Daedalus-TUM/PP_flying_circus/README.md

PP_flying_circus
================

Projektpraktikum Team Flying Circus
