Daedalus-TUM/PP_flying_circus/doku.odt

REGELUNG

#include <PID_v1.h>

void init_PID() {

//init PID-Regler für Höhenregelung

hoehePID.SetOutputLimits(-80, 160); //funktioniert ganz gut

hoehePID.SetMode(AUTOMATIC); //aktiviert PID-Regler

hoehePID.SetSampleTime(200); //Sample Time des PID für die Höhenregelung

//init PID-Regler für Richtungsregelung

richtungsPID.SetOutputLimits(-70, 70);

richtungsPID.SetMode(AUTOMATIC); //aktiviert PID-Regler

richtungsPID.SetSampleTime(200); //Sample Time des PID für die Richtungsregelung

}

PID richtungsPID(&phiFusion, &geschwindigkeit_r, &sollPhi, 5, 0.6, 13, DIRECT);

PID hoehePID(&istH, &geschwindigkeitH, &sollH, 5, 0.6, 13, DIRECT);

vood loop(){

hoehePID.Compute();

richtungsPID.Compute();

}

ABWURF

#define out_Abwurf 1

//Abwurf ausführen, wenn Wegpunkt mit Abwurf erreicht

if(receiving[7] == 1) digitalWrite(out_Abwurf,HIGH); //Pin für Abwurf auf High setzen um Paket abzuwerfen

else if(receiving[7] == 50) sollH = 0; //"deaktiviert" Hoehenregelung

else if(receiving[7] == 0) digitalWrite(out_Abwurf,LOW); //Pin für Abwurf auf Low setzen

NRF

void NRF() {

if(Mirf.dataReady()) {

Mirf.getData(receiving);

//NRF Receive Variablen

int receive_distanz=0;

int receive_sollPhi=0;

int receive_phi = 0;

receive_distanz = receiving[2]; // receive high byte

receive_distanz = receive_distanz << 8; // shift high byte to be high 8 bits

receive_distanz |= receiving[3]; // receive low byte as lower 8 bits

receive_sollPhi = receiving[4]; // receive high byte

receive_sollPhi = receive_sollPhi << 8; // shift high byte to be high 8 bits

receive_sollPhi |= receiving[5]; // receive low byte as lower 8 bits

sollH = receiving[6]; //Uebernehmen der neuen Sollhoehe

receive_phi = receiving[8]; // receive high byte

receive_phi = receive_phi << 8; // shift high byte to be high 8 bits

receive_phi |= receiving[9]; // receive low byte as lower 8 bits

sollPhi = receive_sollPhi;

phiIPS = receive_phi;

}

sending[2] = IPS;

sending[3] = istH;

sending[4] = sollH;

sending[5] = geschwindigkeit_r;

sending[6] = yaw;

sending[7] = sollPhi;

Mirf.send(sending);

while(Mirf.isSending()){

}

}
