Daedalus-TUM/PP_flying_circus/AbschlussprÃ¤sentation/Abschlusspraesentation_Flying_Circus.pdf

# Abschlusspräsentation

Team Flying Circus

Adam Ivankay, Thomas Riethorst, Tobias Eden, Lorenz Kenndoff

Autoren: Adam Ivankay, Thomas Riethorst

# Zielsetzung

- Konstruktion einer autonom flugfähigen Gondel
- kein Zugriff auf das Steuerungssystem während des Wettfluges

08.07.14 2/13 Team Flying Circus Thomas Riethorst, Adam Ivankay, Tobias Eden, Lorenz Kenndoff - Abwurf eines Rettungspakets an einer zuvor definierten Position - Das Luftschiff darf während der gesamten Mission nicht höher als 2 Meter und tiefer als 0,5 Meter fliegen - Die Dauer eines Durchlaufs beträgt maximal 15 Minuten, wobei zwei Durchläufe erlaubt sind

# Vergleich Projektplan: Hardware

- Grundgerüst aus Karbonstangen und herausnehmbaren Komponenten
- Letztendlich kein Umstieg auf zwei Höhenmotoren
- Dual-IPS wurde benutzt und optimiert
- Zusätzliche Bodenstationen
- Funkverbindung NRF-Modul anstatt Xbee
08.07.14 | Team Flying Circus Thomas Riethorst, Adam Ivankay, Tobias Eden, Lorenz Kenndoff | 3/13

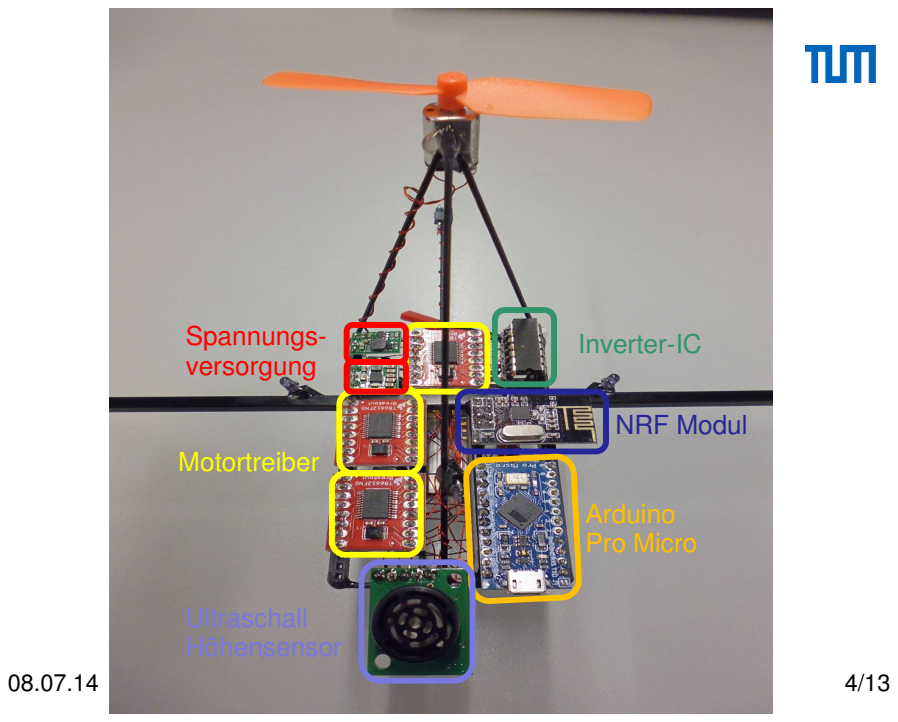
[picture p9: page 4]
Spannungs-; Inverter-IC; Motortreiber; Arduino Pro Micro; NRF Modul; Ultraschall Höhensensor; versorgung

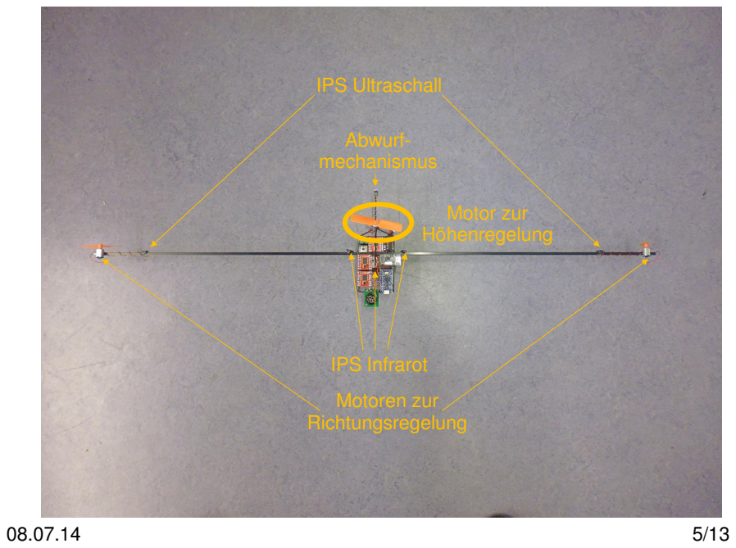
[picture p10: page 5]
IPS Ultraschall; Motor zur Höhenregelung; Abwurf- mechanismus; IPS Infrarot; Motoren zur Richtungsregelung

Gondel-Software:
- Regelung, Sensorik und Motoransteuerung auf dem Arduino - Statt Wegpunkten werden ein Winkel, eine Distanz und eine

# Vergleich Projektplan: Software

Höhe an die Gondel übermittelt

PC-Software:
- Koordinatensystem nach Norden ausgerichtet
- Wegpunkte werden vorher eingetragen und nicht berechnet
08.07.14 | Team Flying Circus Thomas Riethorst, Adam Ivankay, Tobias Eden, Lorenz Kenndoff | 6/13

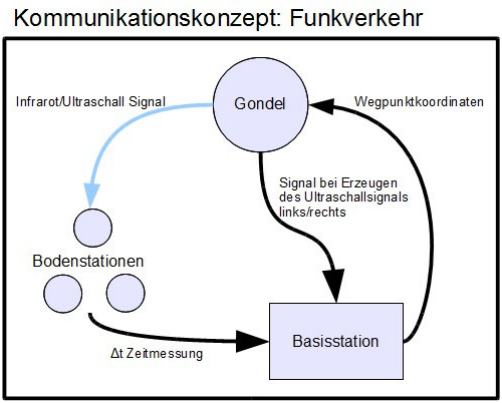
[picture p11: figure]

08.07.14 | Team Flying Circus Thomas Riethorst, Adam Ivankay, Tobias Eden, Lorenz Kenndoff | 7/13

Probleme – Lösungen: - Gondel zerfallen, nicht fest

genug - Genauigkeit vom IPS | - Mehr Verstrebungen eingebaut, mehr Kleber verwendet - mehr Bodenstationen,

physikalische Eigenschaften ausgenutzt, Software überarbeitet - IMU-Board sehr unzuverlässig - Zeitproblem mit Löten der

Bodenstationen | - Richtungsbestimmung über IPS - Mehr Fokus auf dieses Arbeitspaket
08.07.14 | Team Flying Circus Thomas Riethorst, Adam Ivankay, Tobias Eden, Lorenz Kenndoff | 8/13

Probleme – Lösungen: - Selbstimplementierter PID-

Regler nicht funktionsfähig - Fehler im Code - Ausrichtung der Gondel | - Arduino PID Library verwendet - stundenlanges Troubleshooting - zwei IPS-Sender implementiert - Synchronisationsprobleme bei

Dual-IPS - fehleranfällige IPS-

Bodenstationen | - Softwarearchitektur des IPS umschreiben - Verbesserungen im Hardwareaufbau und Layout
08.07.14 | Team Flying Circus Thomas Riethorst, Adam Ivankay, Tobias Eden, Lorenz Kenndoff | 9/13

# Was wurde erreicht?

- Sehr gut funktionierende Höhenregelung implementiert
- Implementierung der Richtungsregelung
- IMU-Rohdaten auslesen und in Richtungswerte umrechnen (Kompass)
- IPS Erweiterungen in Hardware und Software
- stabile Kommunikation zwischen Gondel und PC
- funktionierende Ausrichtung der Gondel
- diverse Testflüge
- zuverlässiger Abwurfmechanismus
08.07.14 | Team Flying Circus Thomas Riethorst, Adam Ivankay, Tobias Eden, Lorenz Kenndoff | 10/13

# Was wurde (noch) nicht erreicht? – Warum?

- vollständige Implementierung
der IPS-Software
- Dokumentation unvollständig
- Python sehr zeitaufwändig - nur einer im Team konnte Python
- Nachlässigkeit der Teammitglieder
- Testflüge für Richtungsregelung im Gesamtsystem
- Aufbau ausreichender Anzahl von Bodenstationen
- IPS-Software nicht vollständig und Simulation nicht aussagekräftig
- mangelnde Unterstützung des zweiten Teams, bedingt durch unzureichende
Kommunikationsbereitschaft
08.07.14 | Team Flying Circus Thomas Riethorst, Adam Ivankay, Tobias Eden, Lorenz Kenndoff | 11/13

# Team - Probleme

- Im späteren Verlauf auftretende Unklarheiten, was als nächstes gemacht werden sollte
- Prioritätensetzung und Zeitaufteilung
- Synchronisation und Abhängigkeit der Arbeitspakete und damit
- kein eindeutig definierter Teamleiter
08.07.14 | Team Flying Circus Thomas Riethorst, Adam Ivankay, Tobias Eden, Lorenz Kenndoff | 12/13

# Persönliche Lernerfolge

- Adam: Erste Erfahrungen in der Elektrotechnik, Verständnis von Mikrocontrollern erweitert, Praktische Anwendungen in der Regelungstechnik, Teamwork, Eigeninitiative
- Lorenz: Verbindung von Software und Hardware, praktische Erfahrungen, Programmierkenntnisse
- Tobias: TBD
- Thomas: Erfahrungen in der Regelungstechnik, Teamwork, Zeitmanagement
08.07.14 | Team Flying Circus Thomas Riethorst, Adam Ivankay, Tobias Eden, Lorenz Kenndoff | 13/13
