Daedalus-TUM/PP_flying_circus/Projektplan Vorlage/projektplan_FlyingCircus.pdf

# Projektplan Team X

### Projektpraktikum Informationsverarbeitung

Tobias Eden, Lorenz Kenndorf, Adam Ivankay, Fabian Kluge

25. April 2014

## Motivation

Das Projektpraktikum Informationsverarbeitung stellt als Hands-on-Projekt die Schnittstelle zwischen Theorie und Praxis dar, welche besonders für Ingenieure von großer Bedeutung ist. Das Thema des autonomen Fluges, welches auch den Schritt in Richtung Forschung macht, bildet damit eine interessante Grundlage für eigene Ideen und Entwicklungen. Dabei werden die während dem Studium angeeigneten Fähigkeiten und Kenntnisse des Teams im Bereich Regelungstechnik und Programmierung erweitert und weiter verbessert. Ein wichtiger Aspekt ist auch der Konkurrenzkampf mit dem anderen Team, da dieser sowohl das Interesse als auch die Motivation aufrecht erhält.

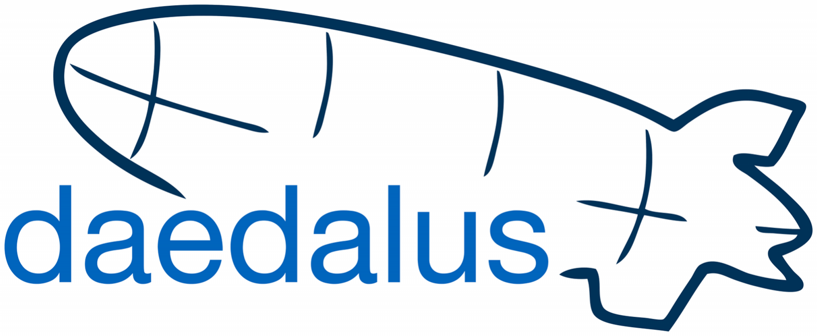
[picture p12: figure]

## 1 Beschreibung des Projekts

### Zielsetzung

In dem dreimonatigen Projektpraktikum soll ein Luftschiff konstruiert werden, welches autonom einen vordefinierten Hindernis-Parcours abfliegt und an einer markierten Stelle ein Rettungspaket abwirft. Dazu müssen folgende Kriterien und Aufgaben eingehalten werden:

-Das Team hat während der Mission keinen Zugriff auf das Steuerungssystem des Luftschiffes -Das Luftschiff soll ein Rettungspaket an einer zuvor definierten Position abwerfen -Das Luftschiff darf während der gesamten Mission nicht höher als 2m und tiefer als 0,5m fliegen -Die Dauer eines Durchlaufs zum Absolvieren der Mission beträgt maximal 15 Minuten, wobei zwei Durchgänge erlaubt sind -Sowohl die Gondel, als auch der Ballon dürfen Hindernisse im Raum nicht berühren

Bei der Entwicklung des Luftschiffes sind Umwelteinflüsse, wie Luftzug, IR-Störung, Helligkeitsund Temperaturänderungen zu beachten. Zusätzlich ist eine gewisse Toleranz in der Tragkraft des Zeppelinballons zu berücksichtigen.

### Ansatz

Unser Team hat sich für einen Ansatz mit drei Motoren entschieden, einen zur Höhenregelung und zwei für die Ausrichtung um die Gierachse. Das Grundgerüst der Gondel soll aus Carbonstangen gefertigt werden, woran der Ausleger für die Motoren befestigt wird. Verwendet wird ein IMU-Board zum Messen von Höhe, Luftdruck, Magnetfeld und Richtung; drei Motortreiber zur Steuerung und das Arduino-Board zur Berechnung der Steuerbefehle.

Für das Projekt stehen uns die Dokumentationen der letztjährigen Teams zur Verfügung, sowie das über die Jahre entwickelte Indoor-Positioning-System (IPS).

Das Gesamtkonzept sieht vor, die Wegfindung am PC zu berechnen. Die aktuellen Positionsdaten sowie die nächsten anzufliegenden Wegpunkte werden am PC berechnet und dann zum Arduino übertragen. Am Arduino wird dann durch die Regelsoftware die notwendige Kursänderung berechnet, die notwendig ist, um den nächsten Wegpunkt, ausgehend von der aktuellen Position, anzufliegen.

### Erfolgskriterien

## 2 Projektumfang und Meilensteine

- Recherche und Planung

– Kostenplanung

– Einarbeitung in das Themengebiet

– Materialbestellung

- Grundgerüst

2

– Design Planung der Bauweise unter Berücksichtigung des Schwerpunktes

– Konstruktion Installation der Bauteile

- Motoren und Motortreiber

– Installation der Motoren und Motortreiber

– Verbindung mit Arduino und Stromversorgung

- Erweiterung des IPS

– Software für Doppelsender konfigurieren

– Testen der Funktionalität des Konzeptes

– Hardware Konstruktion weiterer Bodenstationen

- Sensoren

– IPS Sender installieren

– Auswertung der Genauigkeit der Messdaten

– Optimierung durch Filterung

- Funkverbindung

– Installation des XBEE-Moduls

– Test der Funkverbindung

- Abwurfmechanismus

– Installation der Schaltung

– Test Bestimmung von Drahtdicke und -länge auf experimentelle Weise

- Navigation und Wegfindung

– Auswertung der Messdaten

– Positionsberechnung

– Wegfindungsalgorithmus

– Bestimmung der Wegpunkte

– Umrechnung auf Koordinatensystem der Gondel

- Regelung

– Entwurf der Höhenregelungs- und Richtungsregelungsalgorithmen

– Test Experimentelle Bestimmung der Toleranzbereiche

– Umwelteinflüsse kompensieren

- Dokumentation Festhalten des Projektfortschrittes pro Arbeitspaket

– Materialliste

– Softwarecode mit ausführlichen Kommentaren

3

– Probleme und Lösungen

– Bilder

– Anleitung Navigationssystem, Luftschiffflug

– Quellenangaben

## 3 Projektstruktur

### Grundgerüst

Das Grundgerüst dient der exakten Befestigung aller Komponenten der Gondel.
Als Aufbau unseres Grundgerüsts haben wir uns für einen Skelettaufbau aus Carbonstangen entschieden. Die Stift-/Buchsenleisten werden entsprechend mit den Carbonstangen per Epoxidklebstoff verklebt, um so ein stabiles und dennoch sehr leichtes Grundgerüst für die Gondel zu erhalten. Der Großteil der Elektronik kann somit einfach aufgesteckt und bei Bedarf getauscht werden, sollten Defekte auftreten. Die zwei Motoren zur Richtungsregelung werden an einem Ausleger aus Carbon fixiert, der eine ungefähre Länge von 50cm aufweisen wird.

Die Ultraschall-Sender für das IPS werden jeweils am Ende des Carbonauslegers montiert. Der Infrarotsender wird mittig positioniert. Der Motor zur Höhenregelung wird mittig auf einem kurzen Carbonausleger platziert. Sollten wir aus technischen Gründen (Ausgleich des Drehmoments bei nur einem Motor) auf zwei Motoren für die Höhenregelung umsteigen, werden diese auf dem großen Carbonausleger jeweils auf einer Seite montiert. Um die Trägheit um die Gierachse zu minimieren werden die schwersten Bauteile möglichst nah am Schwer-/Drehpunkt angebracht.

### Motor und Motortreiber

Das Team hat sich primär für einen Antrieb mit drei Motoren entschieden, zwei für die Bewegung in der Ebene, einen für die Höhenregelung. Ein späterer Umstieg auf eine Variante mit zwei Motoren für die Regelung wird offen gehalten. Zur Ansteuerung der Motoren werden insgesamt drei Motorentreiber benötigt. Wir werden kleine, leichte DC-Motoren verwenden, daher können wir einfache Treiber in Form von H-Brücken verwenden. Die Ansteuerung der Treiber wird direkt vom Arduino übernommen. Die Befestigung und Entfernung der Motoren zur Richtungsregelung zum Schwer-/Drehpunkt wird experimentell ermittelt. Dabei muss ein Kompromiss zwischen Leistungsbedarf für eine Drehung und der Problematik einer zu großen Empfindlichkeit durch großen Achsabstand gefunden werden. Bei den Propellern ist darauf zu achten, dass es sich um Typen mit unterschiedlichen Drehrichtungen handeln muss und diese an den Gleichstrommotoren befestigt werden können.

### Sensoren

Das IMU-Board wird, um möglichst störungsfreie Daten zu erhalten, auf der Oberseite des Ballons befestigt. Dadurch können wir die Einflüsse der Magnetfelder der Gleichstrommotoren so gering

4

wie möglich halten. Welche Messdaten verwendet werden können, muss experimentell ermittelt werden. Im Grunde gilt, mit dem Konzept der zwei Ultraschall-Sender auf dem Ausleger lässt sich im Prinzip das IMU-Board einsparen, da es zwei Punkte der Gondel positioniert, und dadurch die Ausrichtung des Ballons auch bestimmt werden kann. Es wird trotzdem verwendet, um mehrere Daten für Höhe, Richtung und Beschleunigung zu erhalten. Des weiteren wird ein Ultraschallsensor zur Höhenmessung eingesetzt.

### Funkverbindung

Um eine Funkverbindung mit dem PC zu erhalten, wird ein XBEE-Modul verwendet. Über diese Kommunikationsverbindung werden dann die Koordinaten von der Basisstation an den Ballon übertragen. Für Tests können damit auch manuelle Steuerungen übernommen werden. Zusätzlich können vom Ballon verschiedene Statuswerte an den PC übertragen werden.

### Abwurfmechanismus

Als Abwurfmechanismus wird ein Transistor zum Durchbrennen eines Drahtes zum Lösen des Pakets verwendet. Die Dicke des Drahtes sowie der benötigte Strom zum Durchbrennen müssen experimentell ermittelt werden. Bei Erreichen der Koordinaten der Abwurfstelle wird die Software im Arduino einen Transistor ansteuern, der dann den dünnen Draht kurzschließt und ihn somit durchbrennt. Dadurch wird das Paket abgeworfen.

### Stromversorgung

Der Akku wird aus zwei Zellen in Serie mit jeweils 3,7V, also insgesamt 7,4V, bestehen. Die Motoren sowie die Ultraschallsender können mit dieser Spannung umgehen. Für die restliche Elektronik werden noch entsprechende Spannungswandler (Schaltregler) für die Spannungen 5V und 3,3V benötigt.

### Navigation und Wegfindung

Aufbauend auf den Positionsdaten des IPS wird auf der Basisstation der optimale Weg durch den Hindernisparcours berechnet. Dieser optimale Weg besteht voraussichtlich aus Kreissegmenten in einem Sicherheitsabstand um die Hindernisse, welche tangential von Hindernis zu Hindernis verbunden werden.

Der Wegfindungsalgorithmus wird bei Flugbegin zunächst einmalig ausgeführt und erzeugt Wegpunkte, welche der Gondel übermittelt werden und von der Regelungssoftware auf der Gondel weiter verarbeitet werden. Der Flug der Gondel wird laufend von der Basisstation auf Kursabweichungen überprüft. Für den Fall dass die Gondel das Ziel verfehlt und somit ein Toleranzwert für das Einhalten des vorgegebenen Kurses überschritten wird, wird der Wegfindungsalgorithmus erneut ausgeführt und die neuen Wegpunkte der Gondel übermittelt.

5

Zur Veranschaulichung der laufenden Prozesse der Navigationssoftware, der Position der Gondel sowie dem Zustand des IPS-Systems soll eine graphische Oberfläche verwendet werden. In der dargestellten Karte werden Hindernisse und spezielle Wegpunkte (z. B. Abwurfort, Ziel) per Eingabe festgelegt. Für Notfälle soll auch eine manuelle Steuerung in die Software integriert werden.

### Regelung

Alle zur Regelung notwendigen Berechnungen werden vom auf der Gondel installierten Arduino-Board übernommen. Es werden lediglich die aktuellen Positionsdaten und die Position des nächsten Wegpunktes an die Gondel übermittelt. Zur Vereinfachung der Berechnungen auf der Gondel werden die Koordinaten vorher auf der Basisstation von einem globalen Koordinatensystem auf das lokale Koordinatensystem der Gondel umgerechnet. Zur Höhenregelung wird ein Ultraschallsensor verwendet, der die Höhe des Ballons ermittelt. Ein entsprechender Höhenregelungsalgorithmus wird direkt auf dem Arduino implementiert.

Bei der Erstellung der Regelung muss darauf geachtet werden, dass das Regelungssystem Umwelteinflüsse wie Zugluft, Druckänderung sowie das durch den einzelnen Höhenregelungsmotor auftretende Drehmoment ausgleichen kann. Weiterhin muss vor allem die Höhenregelung auf den Verlust von ca.1g Gewicht durch Abwurf des Paketes während des Fluges ausgelegt sein.

### Erweiterung des IPS

Beim IPS haben wir uns für einen erweiterten Ansatz entschieden. Da es bei den vorherigen Teams immer wieder zu den Problemen einer genauen Positionsbestimmung sowie Orientierungsbestimmung des Ballons gekommen ist, haben wir hier folgenden Ansatz gewählt. Durch Erweiterung des IPS um die Funktion eines zweiten Senders/Objekts, erhoffen wir uns eine genauere Bestimmung der Position des Ballons. Es werden am Ballon zwei Ultraschallsender jeweils an einem Ende des Auslegers montiert. Diese werden dann abwechselnd, entsprechend den Intervallen des IPS, senden. Dadurch kann die Basisstation zwei Objekte lokalisieren. Die IPS-Software muss entsprechend angepasst werden, sodass die Signale beider Sender getrennt empfangen werden kann.

Durch diese Methode und den geometrischen Eigenschaften der Anordnung der Sender (Abstand zueinander, waagrechte Lage, usw.), erhoffen wir uns somit eine genauere Bestimmung der Position des Ballons. Auch soll es uns dadurch möglich sein, die Orientierung des Ballons berechnen zu können. Diese Werte können dann unterstützend, bzw. sogar ersetzend für das IMU-Board dienen.

Zusätzlich werden weitere IPS-Bodenstationen aufgebaut, um eine bessere Abdeckung zu erreichen. Auch die Neuentwicklung bzw. Verbesserung der Bodenstationen durch gerichtete Ultraschallsensoren wird im Zuge des Projekts getestet und validiert.

6

## 4 Aufwandsabschätzung / Zeitplan

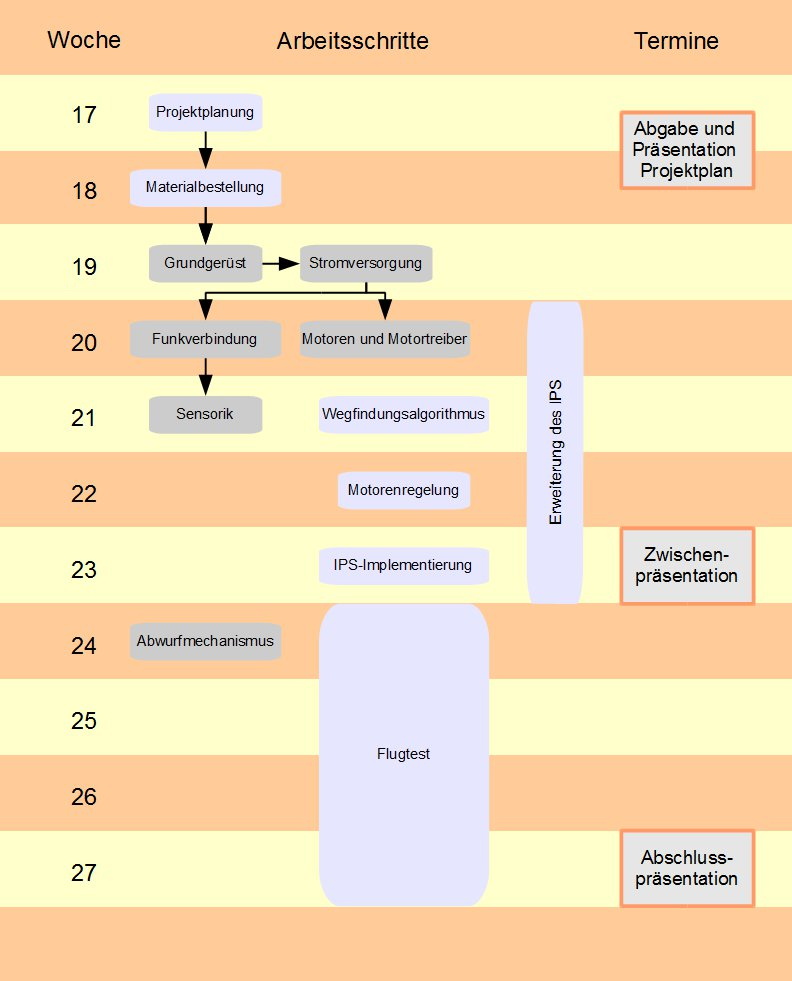
[picture p13: figure]

Wie die Grafik darstellt, werden in den ersten drei Wochen zunächst die Arbeitspakete, welche sich mit der Implementierung der Hardware befassen, bearbeitet. Die darauffolgenden drei Wochen werden zur Entwicklung der Steuersoftware sowie dem Testen der Software auf der Hardware ver-

7

wendet. Während der letzten vier Wochen wird schließlich die Funktionsfähigkeit des Luftschiffes in einem Kreislauf von Test und Optimierung vollendet.

## 5 Material- und Kostenplanung

Die im Bau der Gondel verwendete Hardware (vgl. Absatz „Aufbau des Grundgerüsts“) ist mit den folgenden Kosten verbunden:

Bauteil | Kosten in Euro
==================================
Motoren: | 10
XBEE: | 20
Motorentreiber: | 10
Propeller: | 4
Carbonstangen: | 6
Kleber: | 5
Kabel/Lackdraht: | vorhanden
Arduino-Board: | vorhanden
==================================
Summe: | 55

Für die Motoren und Propeller sind hier bereits Ersatzteile im Preis einkalkuliert.

## 6 Risikoanalyse

Das wichtigste Abbruchkriterium ist das Überschreiten eines geplanten Zeitplans des Arbeitspakets. In dem Fall muss sich das ganze Team auf das Arbeitspaket konzentrieren und daran mitarbeiten. Da es im Team Personen gibt, die im Bereich Informationsverarbeitung Anfänger sind, ist eine realistische Planung vom Zeitaufwand der Arbeitspakete riskant, es müssen eventuell während des Projekts Änderungen vorgenommen werden. Die Evaluation der Meilensteine findet in gemeinsamen Treffen statt, jeweils direkt nach der Deadline des Arbeitspakets.

Ein weiteres Risiko besteht darin, dass die Resourcen nicht vorhanden sind, eventuell nicht zeitig geliefert werden können. Dies kann durch Umplanen und direktem Erscheinen in den Läden korrigiert werden. Der Beschädigung der einzelnen Bauteile wird durch sorgfältiges Einlesen und Informieren so gut wie möglich vorgebeugt.

Hinzu kommt noch, dass bei jedem Arbeitspaket Komplikationen auftreten können, wie z.B. Fehler bei der Programmierung, unvorhergesehene Störungen in der Hardware, konzeptionelle Fehler. In diesen Fällen muss das Team gemeinsam jeweils die bestmögliche Alternative finden (mögliche Risiken: Reichweite des IPS, Fehler im Code, Zwei Punkte-Positionierung des Ballons nicht genau genug, Umwelteinflüsse unberechenbar, Komplikationen mit der Wegberechnung, nicht richtig funktionierendes IPS).

Möglich, aber unwahrscheinlich ist, dass das vorgesehene Budget auf Grund von Beschädigung der Bauelemente nicht ausreicht; in dem Fall muss das Team mit dem Projektleiter konsultieren.

8

## 7 Änderungen des Projektablaufes

Alle auftretenden Änderungen dieses Projektplanes werden beispielsweise in einer Tabelle kurz notiert um Abweichungen und ggf. Änderungen des geplanten Ziels nachvollziehen zu können.

# | DATUM | ÄNDERUNG | GRUND

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
