Daedalus-TUM/PP_flying_circus/Schaltplan.pdf

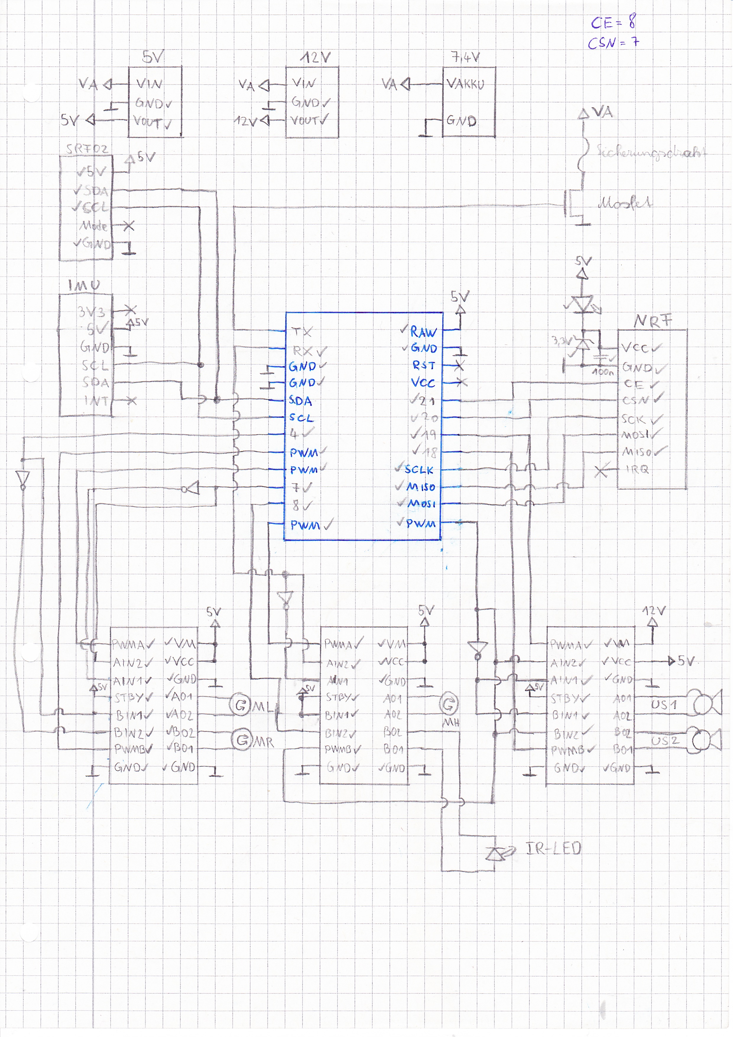
[picture p14: page 1]
