Daedalus-TUM/PP_flying_circus/Projektplan Vorlage/LDVLogoS_oT.pdf

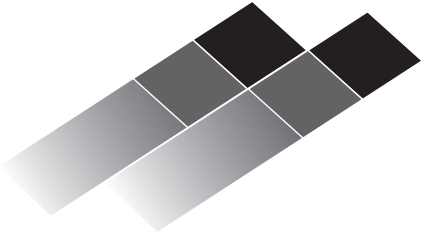
[picture p15: figure]
