Daedalus-TUM/PP_flying_circus/Bleigewichte.jpg

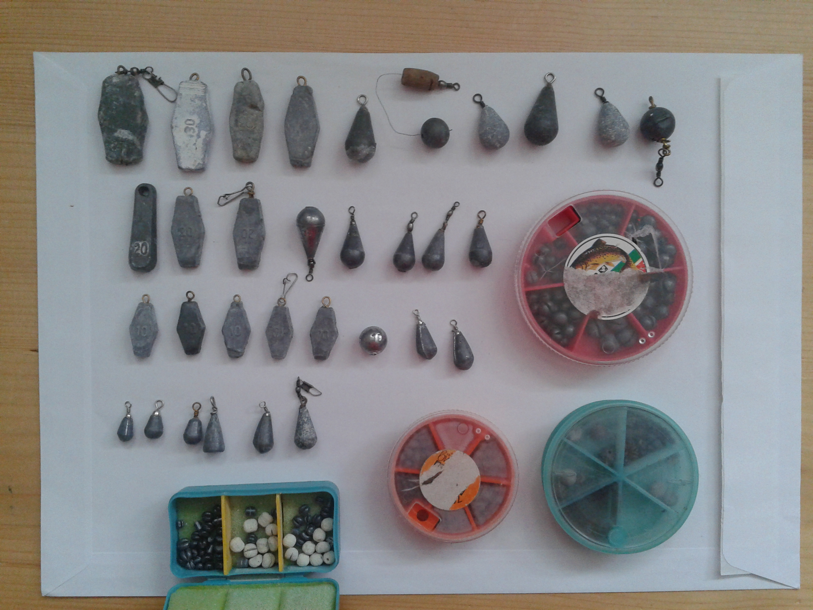
Bleigewichte.jpg
