Daedalus-TUM/PP_flying_circus/Dokumentation/Funk/Funkverkehr.jpg

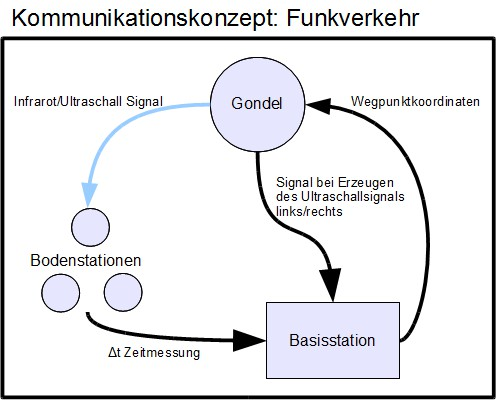
Dokumentation/Funk/Funkverkehr.jpg
