Daedalus-TUM/PP_flying_circus/Dokumentation/Funk/State-Machine.jpg

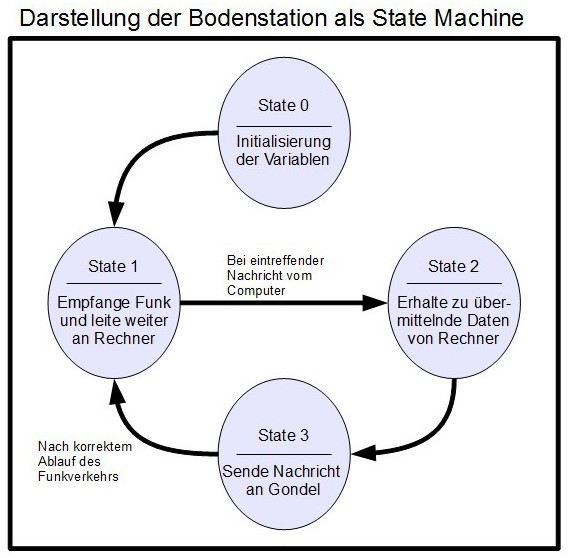
Dokumentation/Funk/State-Machine.jpg
