Daedalus-TUM/PP_flying_circus/IPS/567.png

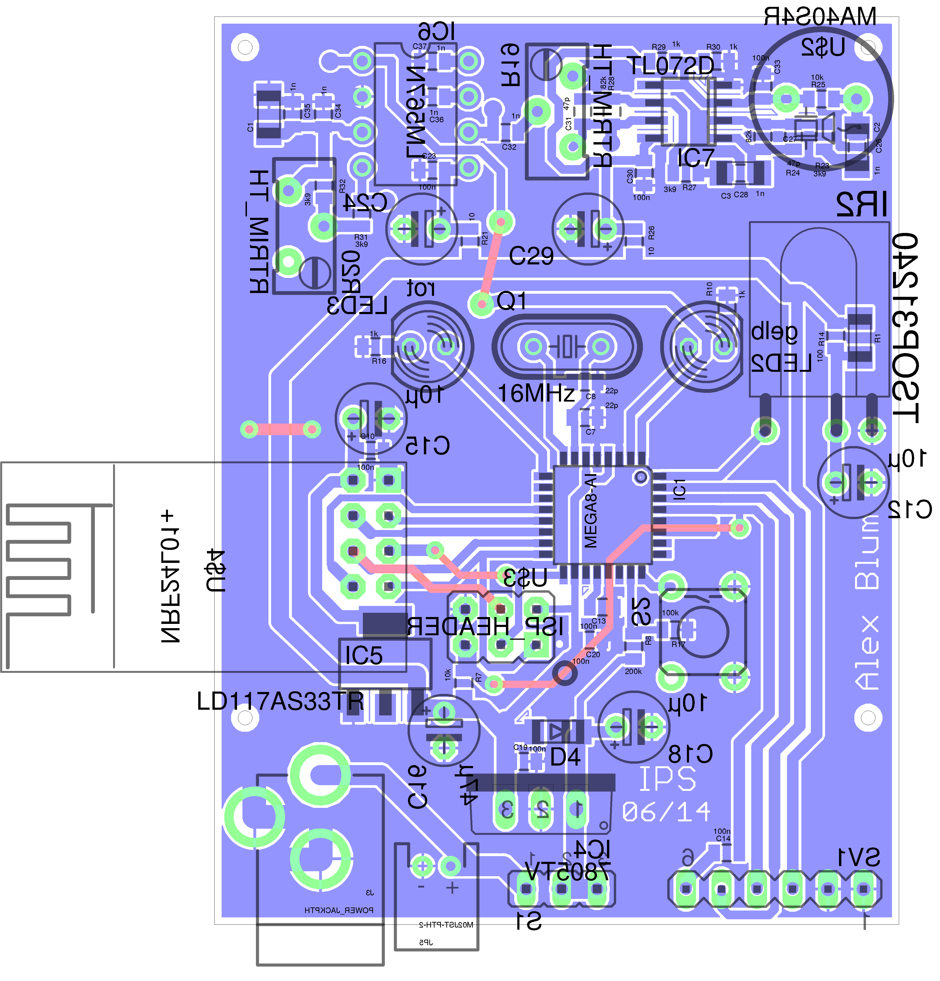
IPS/567.png
