Daedalus-TUM/PP_flying_circus/zwischenprÃ¤sentation/Software Plan/loop_w_timing.jpg

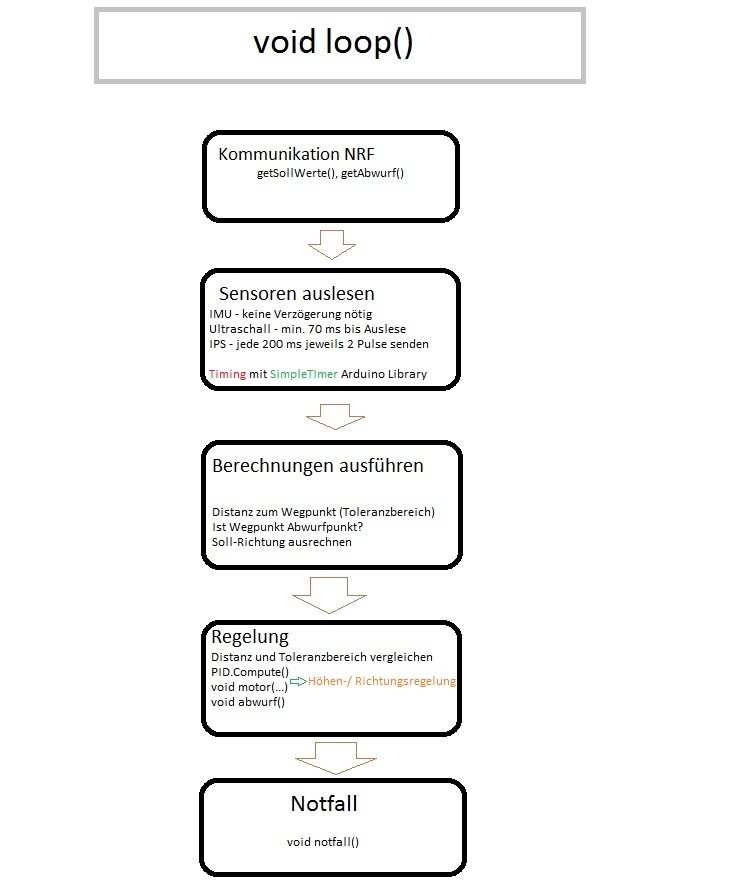
zwischenprÃ¤sentation/Software Plan/loop_w_timing.jpg
