Daedalus-TUM/PP_flying_circus/zwischenprÃ¤sentation/Software Plan/Struktur.jpg

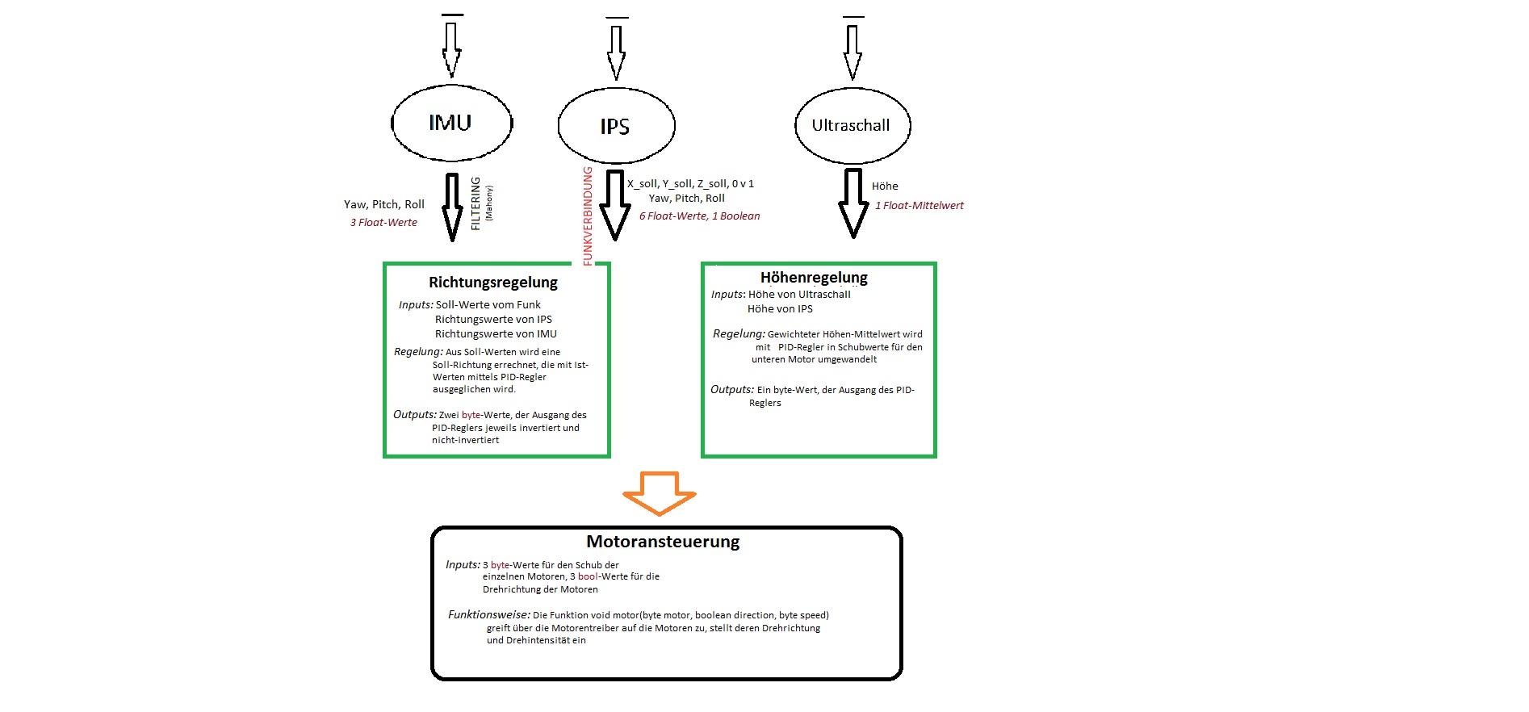
zwischenprÃ¤sentation/Software Plan/Struktur.jpg
