Daedalus-TUM/PP_flying_circus/mpu9150-ms5611.PDF

R2

R1

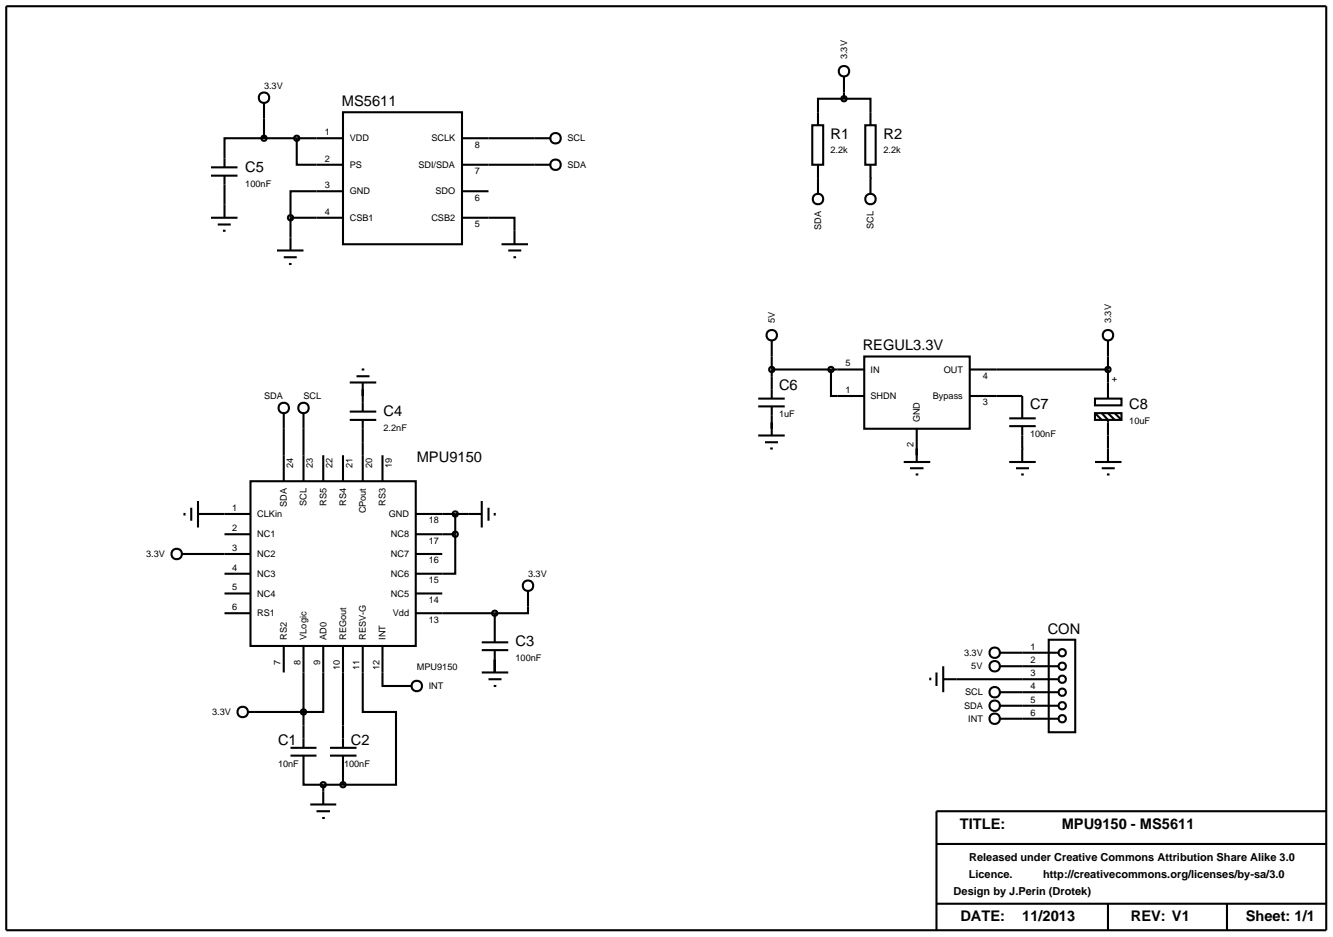
[picture p22: page 1]

Released under Creative Commons Attribution Share Alike 3.0
Design by J.Perin (Drotek)
