Daedalus-TUM/PP_flying_circus/IPS/20140624_empfÃ¤nger_567_frÃ¤se_v2.pdf

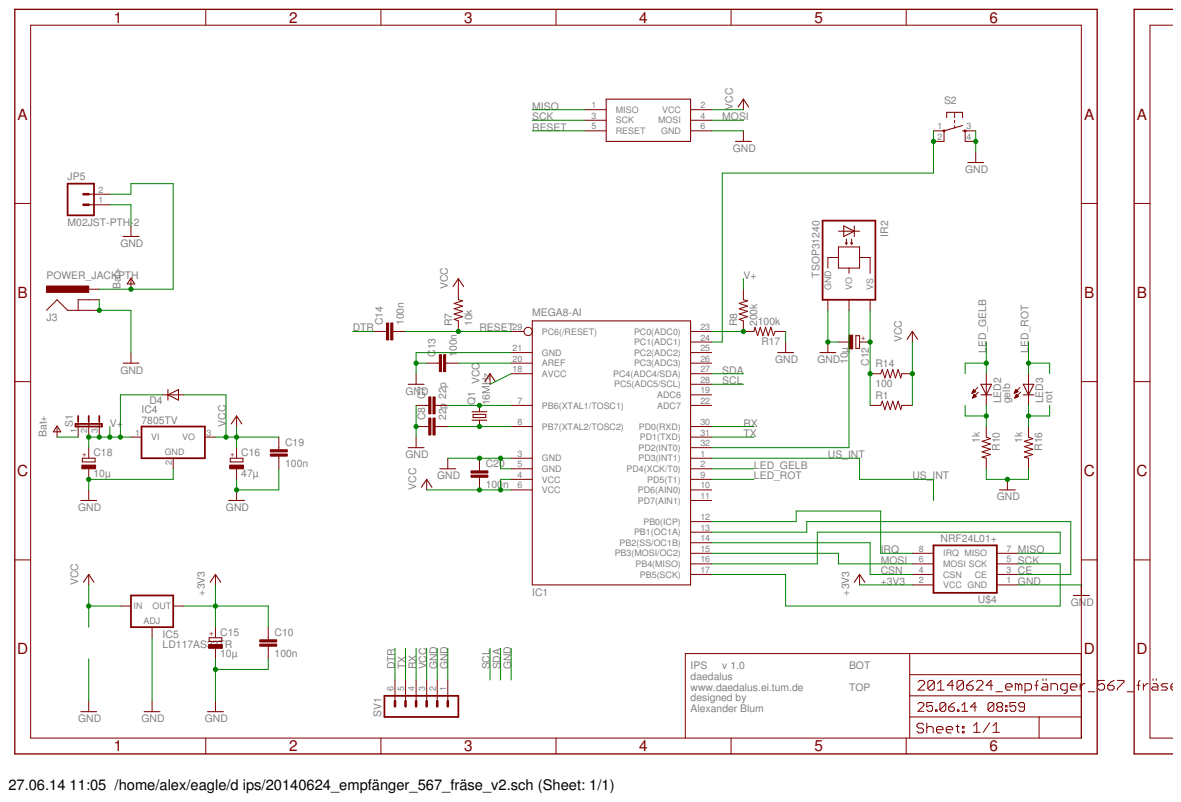
[picture p23: page 1]

IPS v 1.0
daedalus www.daedalus.ei.tum.de
designed by
Alexander Blum

27.06.14 11:05 /home/alex/eagle/d ips/20140624_empfänger_567_fräse_v2.sch (Sheet: 1/1)

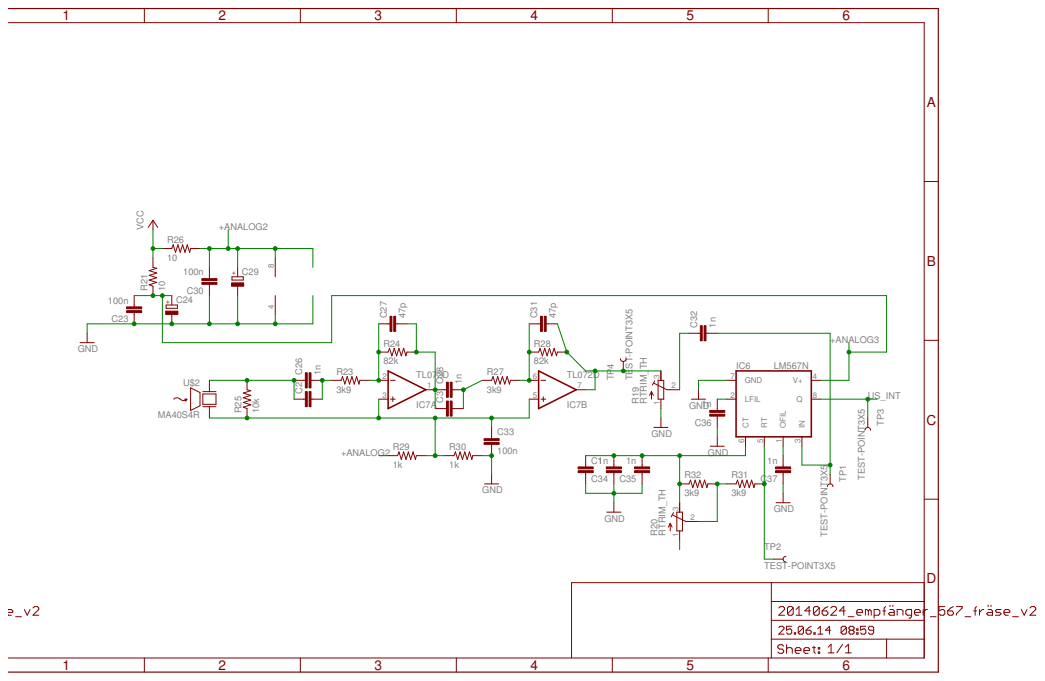
[picture p24: page 2]
