Daedalus-TUM/PP_flying_circus/IPS/20140624_empfÃ¤nger_567_frÃ¤se_v2.brd

## EAGLE design IPS/20140624_empfÃ¤nger_567_frÃ¤se_v2.brd (2014-07-11)

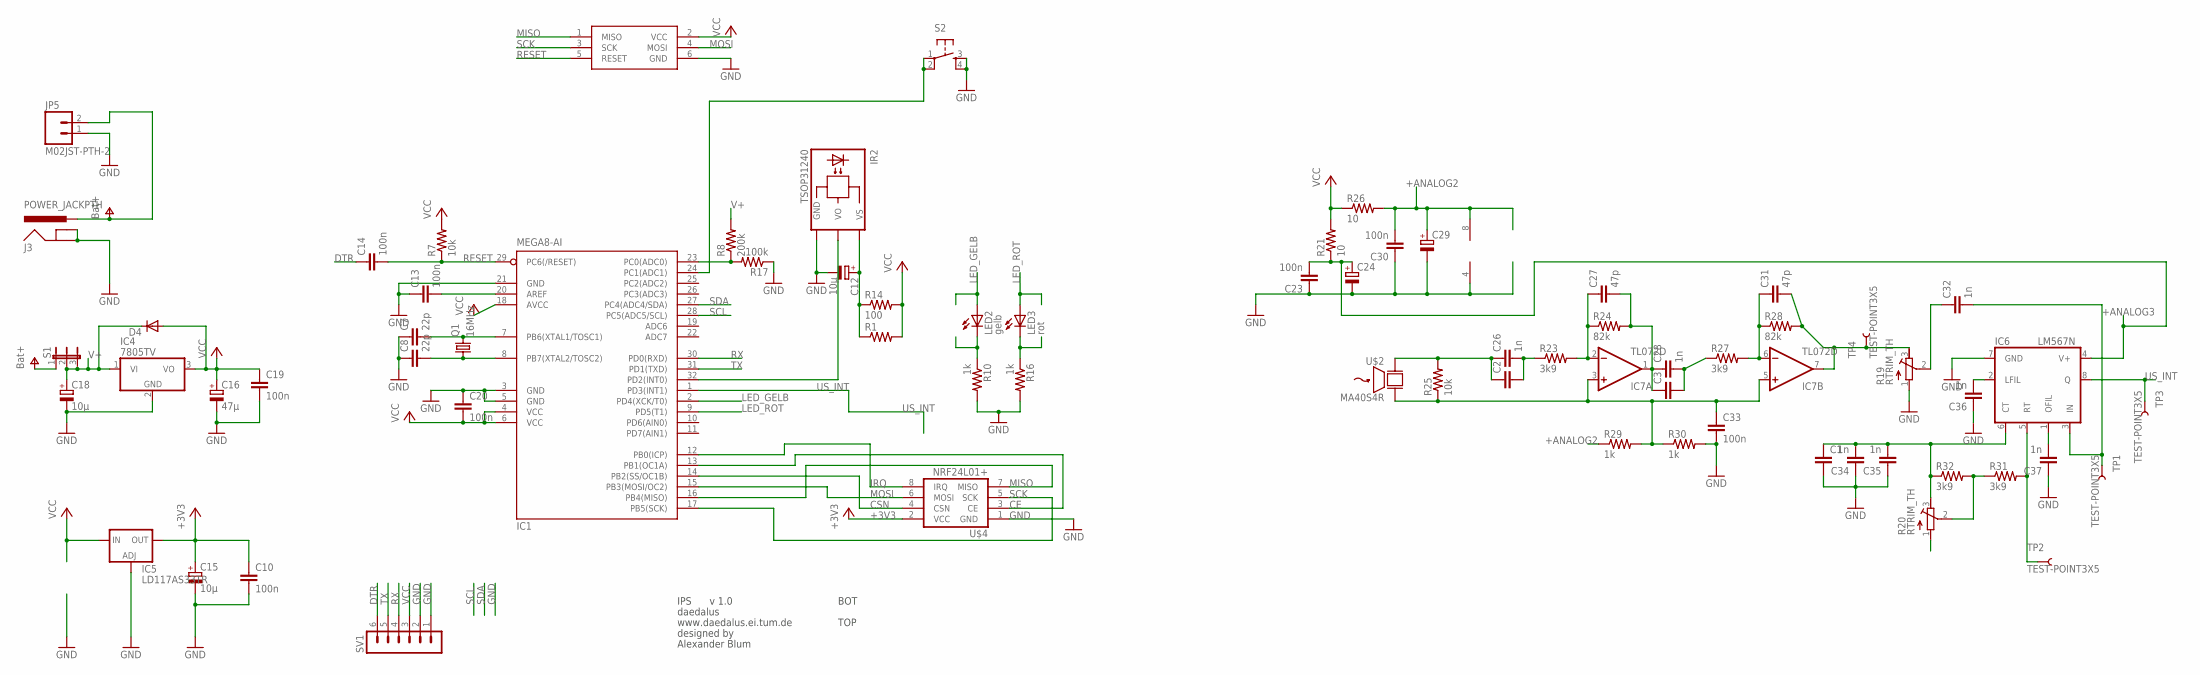
[picture p25: schematic 20140624_empfÃ¤nger_567_frÃ¤se_v2.sch]

Parts:
C1, C2, C3: CAP1206; 1206
C7, C8: 22p; 0805
C10, C13, C14, C19, C20, C23, C30, C33: 100n; 0805
C12, C15, C18: 10µ; E2,5-5
C16: 47µ; E2,5-5
C24, C29: CPOL-EUE2.5-5; E2,5-5
C26, C28, C32, C34, C35, C36, C37: 1n; 0805
C27, C31: 47p; 0805
D4: DIODE-MINIMELF; MINIMELF
IC1: MEGA8-AI; TQFP32-08
IC4: 7805TV; TO220V
IC5: LD117AS33TR; SOT223
IC6: LM567N; DIL08
IC7: TL072D; SO08
IR2: TSOP31240
J3: POWER_JACKPTH; POWER_JACK_PTH
JP5: M02JST-PTH-2; JST-2-PTH
LED2: gelb; LED5MM
LED3: rot; LED5MM
Q1: 16MHz; HC49/S
R1: RESISTOR1206; 1206
R7, R25: 10k; 0805
R8: 200k; 0805
R10, R16, R29, R30: 1k; 0805
R14: 100; 0805
R17: 100k; 0805
R19, R20: RTRIM_TH
R21, R26: 10; 0805
R23, R27, R31, R32: 3k9; 0805
R24, R28: 82k; 0805
S1: JP2E; JP2
S2: TAC_SWITCHPTH; TACTILE-PTH
SV1: MA06-1
TP1, TP2, TP3, TP4: TEST-POINT3X5; PAD.03X.05
U$2: MA40S4R; MUS40
U$3: ISP_HEADER
U$4: NRF24L01+; NRF24

Connections:
+3V3: C10.1, C15.+, IC5.4 (OUT), U$4.2 (VCC)
+ANALOG2: C29.+, C30.2, IC7.8 (V+), R26.2, R29.1
+ANALOG3: C23.2, C24.+, IC6.4 (V+), R21.1
BAT+: J3.PWR, JP5.2, S1.1
CE: IC1.13 (PB1(OC1A)), U$4.3 (CE)
CSN: IC1.14 (PB2(SS/OC1B)), U$4.4 (CSN)
DTR: C14.1, SV1.6
GND: C1.2, C7.1, C8.1, C10.2, C12.-, C13.1, C15.-, C16.-, C18.-, C19.2, C20.1, C23.1, C24.-, C29.-, C30.1, C33.2, C34.1, C35.1, C36.1, C37.1, IC1.3 (GND), IC1.5 (GND), IC1.21 (GND), IC4.2 (GND), IC5.1 (ADJ), IC6.7 (GND), IC7.4 (V-), IR2.GND, J3.GND, J3.GNDBREAK, JP5.1, R10.2, R16.2, R17.1, R19.1 (E), R30.2, S2.3, S2.4, SV1.1, SV1.2, U$3.6 (GND), U$4.1 (GND)
IRQ: IC1.12 (PB0(ICP)), U$4.8 (IRQ)
LED_GELB: IC1.2 (PD4(XCK/T0)), LED2.A
LED_ROT: IC1.9 (PD5(T1)), LED3.A
MISO: IC1.16 (PB4(MISO)), U$3.1 (MISO), U$4.7 (MISO)
MOSI: IC1.15 (PB3(MOSI/OC2)), U$3.4 (MOSI), U$4.6 (MOSI)
unnamed: C7.2, IC1.7 (PB6(XTAL1/TOSC1)), Q1.2
unnamed: C12.+, IR2.VS, R1.1, R14.1
unnamed: C8.2, IC1.8 (PB7(XTAL2/TOSC2)), Q1.1
unnamed: IC1.23 (PC0(ADC0)), R8.1, R17.2
unnamed: IC1.32 (PD2(INT0)), IR2.VO
unnamed: R20.2 (S), R31.1, R32.2
unnamed: C13.2, IC1.20 (AREF)
unnamed: LED2.K (C), R10.1
unnamed: LED3.K (C), R16.1
unnamed: C2.2, C26.2, R23.1
unnamed: C27.1, IC7.2 (-IN), R23.2, R24.1
unnamed: C3.1, C27.2, C28.1, IC7.1 (OUT), R24.2
unnamed: C3.2, C28.2, R27.1
unnamed: C2.1, C26.1, R25.2, U$2.2
unnamed: IC6.5 (RT), R31.2, TP2.P$1
unnamed: C33.1, IC7.3 (+IN), IC7.5 (+IN), R25.1, R29.2, R30.1, U$2.1
unnamed: IC1.24 (PC1(ADC1)), S2.1, S2.2
unnamed: C31.1, IC7.6 (-IN), R27.2, R28.1
unnamed: C1.1, C34.2, C35.2, IC6.6 (CT), R20.3 (A), R32.1
unnamed: C31.2, IC7.7 (OUT), R19.3 (A), R28.2, TP4.P$1
unnamed: C32.1, R19.2 (S)
unnamed: C32.2, IC6.3 (IN), TP1.P$1
unnamed: C37.2, IC6.1 (OFIL)
unnamed: C36.2, IC6.2 (LFIL)
RESET: C14.2, IC1.29 (PC6(/RESET)), R7.1, U$3.5 (RESET)
RX: IC1.30 (PD0(RXD)), SV1.4
SCK: IC1.17 (PB5(SCK)), U$3.3 (SCK), U$4.5 (SCK)
SCL: IC1.28 (PC5(ADC5/SCL))
SDA: IC1.27 (PC4(ADC4/SDA))
TX: IC1.31 (PD1(TXD)), SV1.5
US_INT: IC1.1 (PD3(INT1)), IC6.8 (Q), TP3.P$1
V+: C18.+, D4.C, IC4.1 (VI), R8.2, S1.2, S1.3
VCC: C16.+, C19.1, C20.2, D4.A, IC1.4 (VCC), IC1.6 (VCC), IC1.18 (AVCC), IC4.3 (VO), IC5.3 (IN), R1.2, R7.2, R14.2, R21.2, R26.1, SV1.3, U$3.2 (VCC)

Notes on the sheet:
IPS
v 1.0
daedalus
www.daedalus.ei.tum.de
designed by
Alexander Blum
BOT
TOP

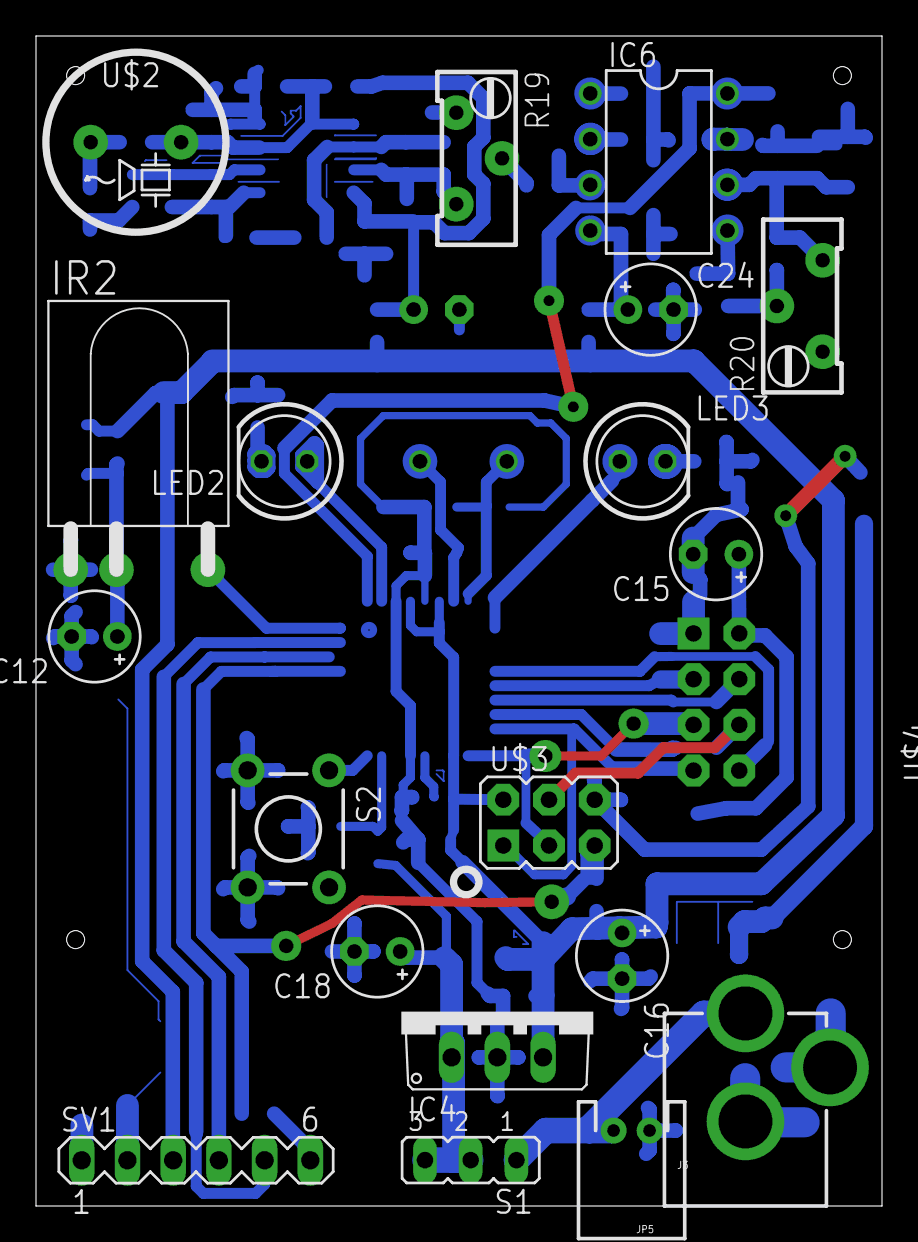
[picture p26: board 20140624_empfÃ¤nger_567_frÃ¤se_v2.brd from above]

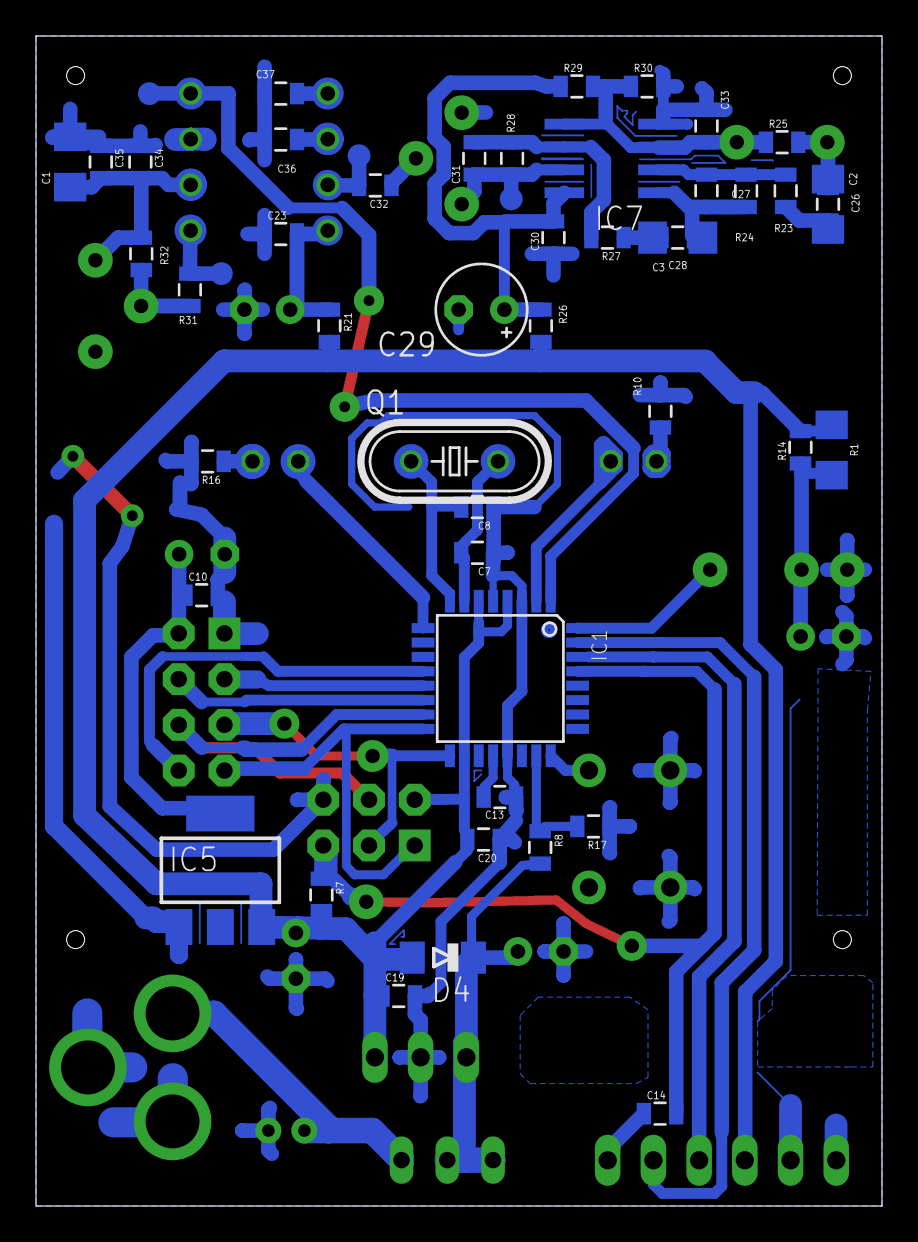
[picture p27: board 20140624_empfÃ¤nger_567_frÃ¤se_v2.brd from below]

Board: 2 copper layers, 47.0 x 65.0 mm, 70 parts (50 on the bottom side), 44 nets.
