Daedalus-TUM/PP_flying_circus/Arduino/IMU-Board/MPU9150_raw/MPU9150_raw.ino

// I2C device class (I2Cdev) demonstration Arduino sketch for MPU9150
// 1/4/2013 original by Jeff Rowberg <jeff@rowberg.net> at https://github.com/jrowberg/i2cdevlib
//          modified by Aaron Weiss <aaron@sparkfun.com>
//
// Changelog:
//     2011-10-07 - initial release
//     2013-1-4 - added raw magnetometer output

/* ============================================
I2Cdev device library code is placed under the MIT license

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
THE SOFTWARE IS PROVIDED "AS IS", WITHOUT WARRANTY OF ANY KIND, EXPRESS OR
IMPLIED, INCLUDING BUT NOT LIMITED TO THE WARRANTIES OF MERCHANTABILITY,
FITNESS FOR A PARTICULAR PURPOSE AND NONINFRINGEMENT. IN NO EVENT SHALL THE
AUTHORS OR COPYRIGHT HOLDERS BE LIABLE FOR ANY CLAIM, DAMAGES OR OTHER
LIABILITY, WHETHER IN AN ACTION OF CONTRACT, TORT OR OTHERWISE, ARISING FROM,
OUT OF OR IN CONNECTION WITH THE SOFTWARE OR THE USE OR OTHER DEALINGS IN
THE SOFTWARE.
===============================================
*/

// Arduino Wire library is required if I2Cdev I2CDEV_ARDUINO_WIRE implementation
// is used in I2Cdev.h
#include "Wire.h"

// I2Cdev and MPU6050 must be installed as libraries, or else the .cpp/.h files
// for both classes must be in the include path of your project
#include "I2Cdev.h"
#include "MPU6050.h"

// class default I2C address is 0x68
// specific I2C addresses may be passed as a parameter here
// AD0 low = 0x68 (default for InvenSense evaluation board)
// AD0 high = 0x69
MPU6050 accelgyro(0x69);

int16_t ax, ay, az;
int16_t gx, gy, gz;
int16_t mx, my, mz;

float Ax[10], Ay[10], Az[10], Gx[10], Gy[10], Gz[10], Mx[10], My[10], Mz[10];
float AX=0, AY=0, AZ=0, GX=0, GY=0, GZ=0, MX=0, MY=0, MZ=0;
int i = 0, j=0;
float tempax=0, tempay=0, tempaz=0, tempgx=0, tempgy=0, tempgz=0, tempmx=0, tempmy=0, tempmz=0;

#define LED_PIN 13
bool blinkState = false;


void setup() {
    // join I2C bus (I2Cdev library doesn't do this automatically)
    Wire.begin();

    // initialize serial communication
    // (38400 chosen because it works as well at 8MHz as it does at 16MHz, but
    // it's really up to you depending on your project)
    Serial.begin(38400);

    // initialize device
    Serial.println("Initializing I2C devices...");
    accelgyro.initialize();

    // verify connection
    Serial.println("Testing device connections...");
    Serial.println(accelgyro.testConnection() ? "MPU6050 connection successful" : "MPU6050 connection failed");

    // configure Arduino LED for
    pinMode(LED_PIN, OUTPUT);
}

void loop() {
    // read raw accel/gyro measurements from device
    accelgyro.getMotion9(&ax, &ay, &az, &gx, &gy, &gz, &mx, &my, &mz);
   
   
    ax=ax/16.384*9.81;    //Daten in Einhetien ausgeben (mm/s2, cgrad/s2, microT)
    ay=ay/16.384*9.81;
    az=az/16.384*9.81;
    
    gx=gx/1.31;
    gy=gy/1.31;
    gz=gz/1.31;
    
    mx=mx*0.3;
    my=my*0.3;
    mz=mz*0.3;
    
    
    
    
  if(i>9){
     i=0;}                              //Mittelwertbildung
   Ax[i]=ax; Ay[i]=ay; Az[i]=az;
   Gx[i]=gx; Gy[i]=gy; Gz[i]=gz;
   Mx[i]=mx; My[i]=my; Mz[i]=mz;
   
  i=i+1;
  
  tempax=0;
  tempay=0;
  tempaz=0;
  tempgx=0;
  tempgy=0;
  tempgz=0;
  tempmx=0;
  tempmy=0;
  tempmz=0;
  
  for(j=0;j<10;j++){
    tempax=tempax+Ax[j];
    tempay=tempay+Ay[j];
    tempaz=tempaz+Az[j];
    tempgx=tempgx+Gx[j];
    tempgy=tempgy+Gy[j];
    tempgz=tempgz+Gz[j];
    tempmx=tempmx+Mx[j];
    tempmy=tempmy+My[j];
    tempmz=tempmz+Mz[j];
  }
 AX=tempax/10;
 AY=tempay/10;
 AZ=tempaz/10;
 GX=tempgx/10;
 GY=tempgy/10;
 GZ=tempgz/10;
 MX=tempmx/10;
 MY=tempmy/10;
 MZ=tempmz/10;
 
  
 
  
  
    // these methods (and a few others) are also available
    //accelgyro.getAcceleration(&ax, &ay, &az);
    //accelgyro.getRotation(&gx, &gy, &gz);

    // display tab-separated accel/gyro x/y/z values
    Serial.print("a/g/m:\t");Serial.print("\n");
    Serial.print(ax); Serial.print("mm/s2"); Serial.print("\t");
    Serial.print("AX: ");Serial.print(AX); Serial.print("\t");
    Serial.print(ay); Serial.print("mm/s2"); Serial.print("\t");
    Serial.print("AY: ");Serial.print(AY); Serial.print("\t");
    Serial.print(az); Serial.print("mm/s2"); Serial.print("\t");
    Serial.print("AZ ");Serial.print(AZ); Serial.print("\t");
    Serial.print("\n");
    Serial.print(gx); Serial.print("cgrad/s2"); Serial.print("\t");
    Serial.print("GX ");Serial.print(GX); Serial.print("\t");
    Serial.print(gy); Serial.print("cgrad/s2"); Serial.print("\t");
    Serial.print("GY ");Serial.print(GY); Serial.print("\t");
    Serial.print(gz); Serial.print("cgrad/s2"); Serial.print("\t");
    Serial.print("GZ ");Serial.print(GZ); Serial.print("\t");
    Serial.print("\n");
    Serial.print(mx); Serial.print("microT"); Serial.print("\t");
    Serial.print("MX ");Serial.print(MX); Serial.print("\t");
    Serial.print(my); Serial.print("microT"); Serial.print("\t");
    Serial.print("MY ");Serial.print(MY); Serial.print("\t");
    Serial.print(mz); Serial.print("microT");Serial.print("\t");
    Serial.print("MZ ");Serial.print(MZ); Serial.print("\t");
    Serial.print("\n");Serial.print("\n");
    
    delay(500);

    // blink LED to indicate activity
    blinkState = !blinkState;
    digitalWrite(LED_PIN, blinkState);
}
